DF4IAH/LandCruiser-Controller/README.md

# LandCruiser-Controller
µP controller for enabling LandCruisers for special tail-gates, alarms and multiple other features based on ATmega328P. Hardware (EAGLE), Software and Documentation is included.
