DF4IAH/LandCruiser-Controller/Docs/11_Brainstorming-Mindmap_Ideas/LandCruiser-Controller-Dateien/image001.png

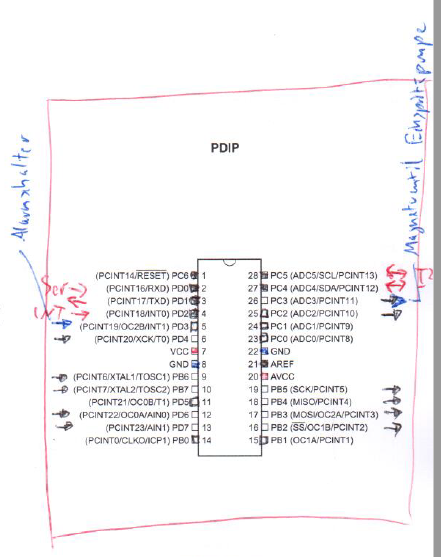
Docs/11_Brainstorming-Mindmap_Ideas/LandCruiser-Controller-Dateien/image001.png
