DF4IAH/LandCruiser-Controller/Docs/11_Brainstorming-Mindmap_Ideas/LandCruiser-Controller-Dateien/image002.png

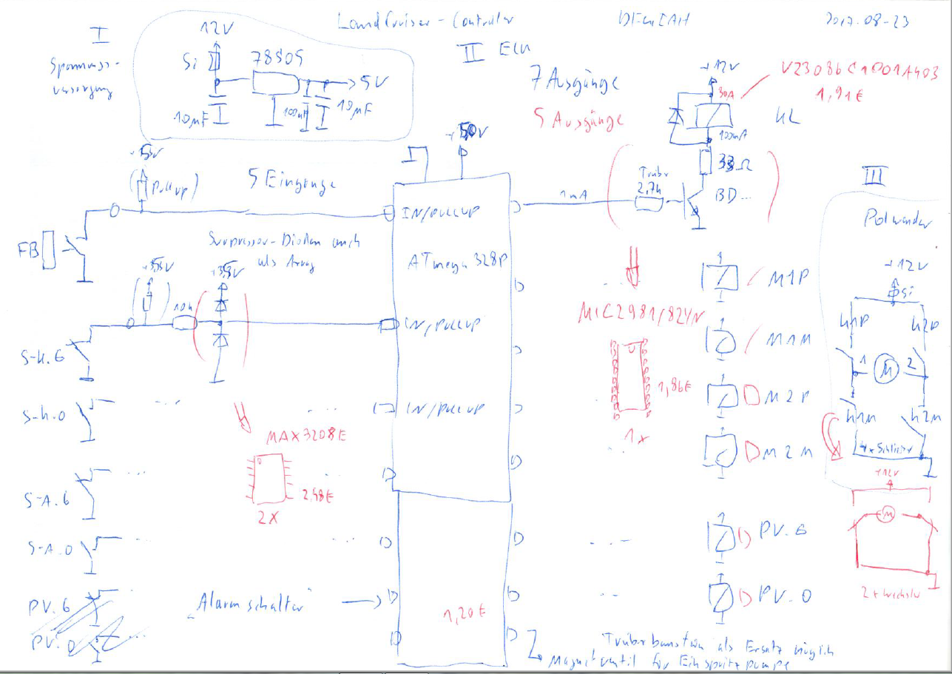
Docs/11_Brainstorming-Mindmap_Ideas/LandCruiser-Controller-Dateien/image002.png
