DF4IAH/LandCruiser-Controller/CAD/Eagle/LandCruiser-Controller_1V0.brd

## EAGLE design CAD/Eagle/LandCruiser-Controller_1V0.brd (2017-09-03)

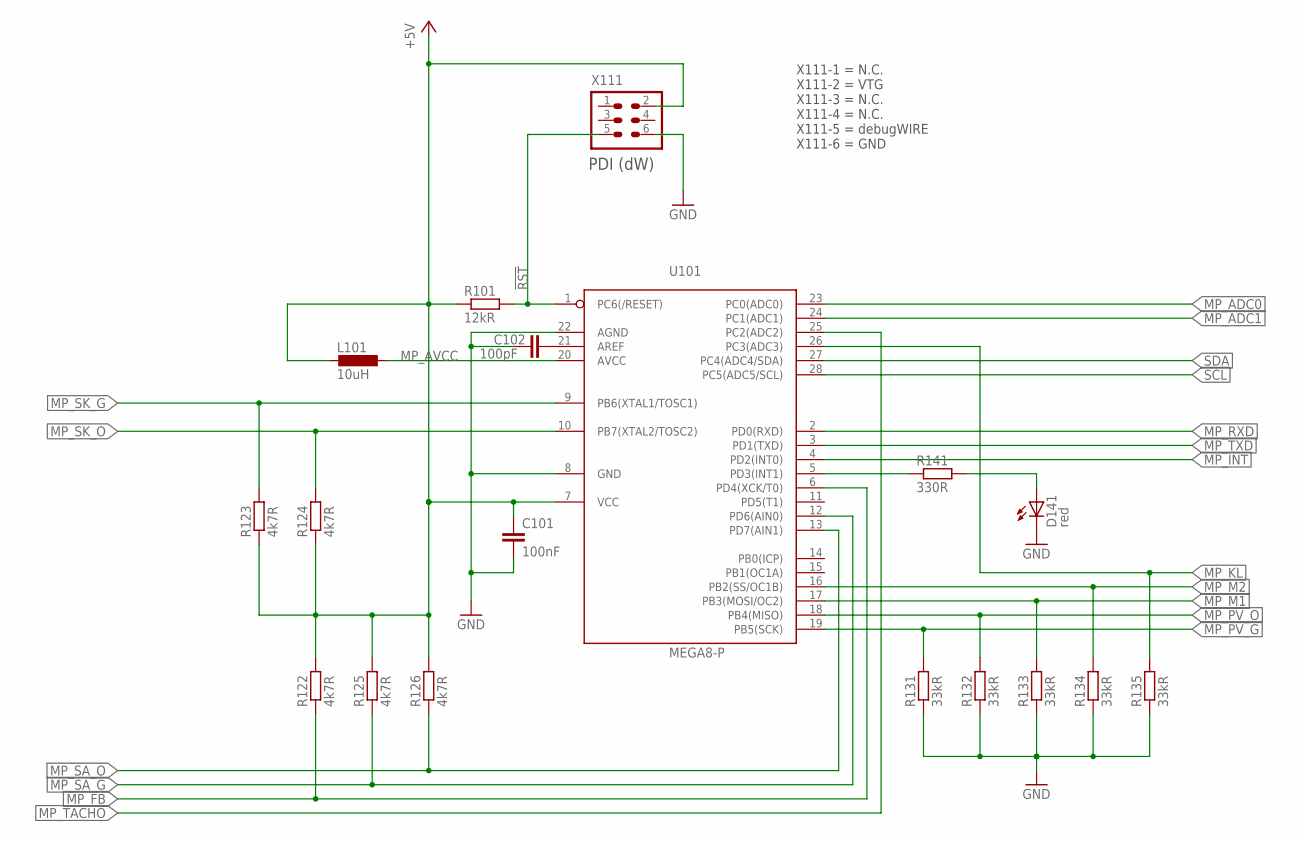
[picture p3: schematic LandCruiser-Controller_1V0.sch, sheet 1, MPU]

Parts:
C101: 100nF; C0805
C102: 100pF; C0805
D141: red; LED_2PIN-TTH
L101: 10uH; L1812
R101: 12kR; R0805
R122, R123, R124, R125, R126: 4k7R; R0805
R131, R132, R133, R134, R135: 33kR; R0805
R141: 330R; R0805
U101: MEGA8-P; DIL28-3
X111: HEADER-2X3; 2X03

Connections:
!RST: R101.2, U101.1 (PC6(/RESET)), X111.5
+5V: C101.1, L101.2, R101.1, R122.2, R123.1, R124.1, R125.2, R126.2, U101.7 (VCC), X111.2; also elsewhere on the board
GND: C101.2, C102.1, D141.C, R131.1, R132.1, R133.1, R134.1, R135.1, U101.8 (GND), U101.22 (AGND), X111.6; also elsewhere on the board
LED_A: D141.A, R141.2
MP_ADC0: U101.23 (PC0(ADC0)); also elsewhere on the board
MP_ADC1: U101.24 (PC1(ADC1))
MP_AREF: C102.2, U101.21 (AREF)
MP_AVCC: L101.1, U101.20 (AVCC)
MP_FB: R122.1, U101.6 (PD4(XCK/T0)); also elsewhere on the board
MP_INT: U101.4 (PD2(INT0))
MP_KL: R135.2, U101.26 (PC3(ADC3)); also elsewhere on the board
MP_LED: R141.1, U101.5 (PD3(INT1))
MP_M1: R133.2, U101.17 (PB3(MOSI/OC2)); also elsewhere on the board
MP_M2: R134.2, U101.16 (PB2(SS/OC1B)); also elsewhere on the board
MP_PV_G: R131.2, U101.19 (PB5(SCK)); also elsewhere on the board
MP_PV_O: R132.2, U101.18 (PB4(MISO)); also elsewhere on the board
MP_RXD: U101.2 (PD0(RXD)); also elsewhere on the board
MP_SA_G: R125.1, U101.12 (PD6(AIN0)); also elsewhere on the board
MP_SA_O: R126.1, U101.13 (PD7(AIN1)); also elsewhere on the board
MP_SK_G: R123.2, U101.9 (PB6(XTAL1/TOSC1)); also elsewhere on the board
MP_SK_O: R124.2, U101.10 (PB7(XTAL2/TOSC2)); also elsewhere on the board
MP_TACHO: U101.25 (PC2(ADC2)); also elsewhere on the board
MP_TXD: U101.3 (PD1(TXD)); also elsewhere on the board
SCL: U101.28 (PC5(ADC5/SCL)); also elsewhere on the board
SDA: U101.27 (PC4(ADC4/SDA)); also elsewhere on the board

Notes on the sheet:
PDI (dW)
X111-1 = N.C. X111-2 = VTG X111-3 = N.C. X111-4 = N.C. X111-5 = debugWIRE X111-6 = GND

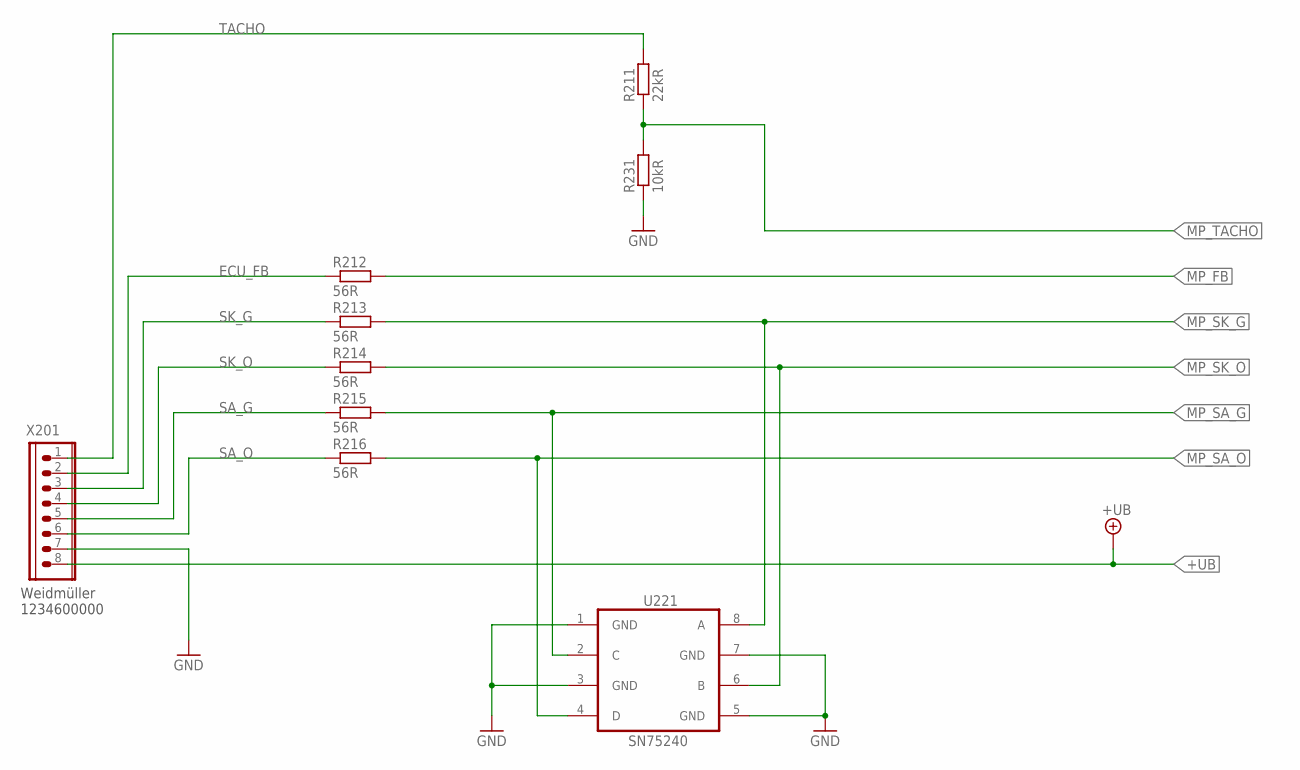
[picture p4: schematic LandCruiser-Controller_1V0.sch, sheet 2, INPUT_Lines]

Parts:
R211: 22kR; R0805
R212, R213, R214, R215, R216: 56R; R0805
R231: 10kR; R0805
U221: SN75240; TSSOP-8
X201: WEIDMUELLER 1234600000; WIRE-TO-BOARD_5MM08_1X08

Connections:
+UB: X201.8; also elsewhere on the board
ECU_FB: R212.1, X201.2
GND: R231.1, U221.1 (GND), U221.3 (GND), U221.5 (GND), U221.7 (GND), X201.7; also elsewhere on the board
MP_FB: R212.2; also elsewhere on the board
MP_SA_G: R215.2, U221.2 (C); also elsewhere on the board
MP_SA_O: R216.2, U221.4 (D); also elsewhere on the board
MP_SK_G: R213.2, U221.8 (A); also elsewhere on the board
MP_SK_O: R214.2, U221.6 (B); also elsewhere on the board
MP_TACHO: R211.1, R231.2; also elsewhere on the board
SA_G: R215.1, X201.5
SA_O: R216.1, X201.6
SK_G: R213.1, X201.3
SK_O: R214.1, X201.4
TACHO: R211.2, X201.1

Notes on the sheet:
Weidmüller 1234600000

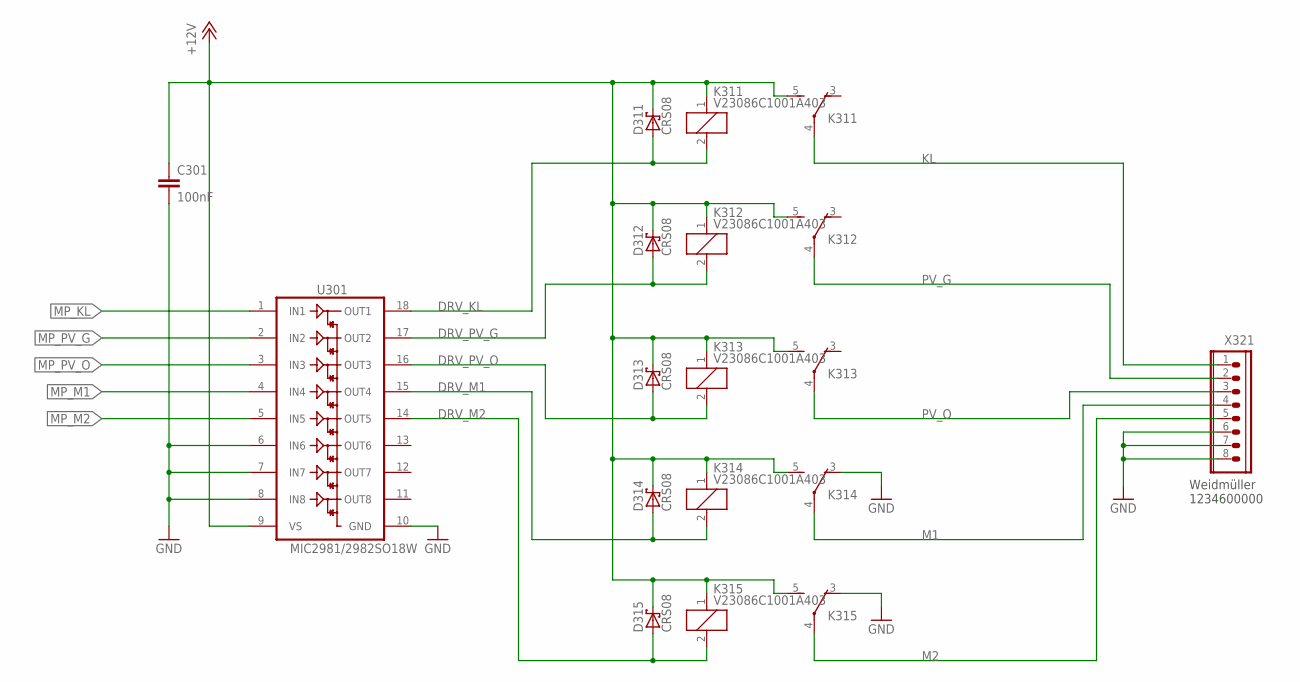
[picture p5: schematic LandCruiser-Controller_1V0.sch, sheet 3, OUTPUT_Lines]

Parts:
C301: 100nF; C0805
D311, D312, D313, D314, D315: CRS08; SOD80C
K311, K312, K313, K314, K315: V23086C1001A403; V23086-CO
U301: MIC2981/2982SO18W; SO-18W
X321: WEIDMUELLER 1234600000; WIRE-TO-BOARD_5MM08_1X08

Connections:
+12V: C301.1, D311.C, D312.C, D313.C, D314.C, D315.C, K311.1, K311.5 (S), K312.1, K312.5 (S), K313.1, K313.5 (S), K314.1, K314.5 (S), K315.1, K315.5 (S), U301.9 (VS); also elsewhere on the board
DRV_KL: D311.A, K311.2, U301.18 (OUT1)
DRV_M1: D314.A, K314.2, U301.15 (OUT4)
DRV_M2: D315.A, K315.2, U301.14 (OUT5)
DRV_PV_G: D312.A, K312.2, U301.17 (OUT2)
DRV_PV_O: D313.A, K313.2, U301.16 (OUT3)
GND: C301.2, K314.3 (O), K315.3 (O), U301.6 (IN6), U301.7 (IN7), U301.8 (IN8), U301.10 (GND), X321.6, X321.7, X321.8; also elsewhere on the board
KL: K311.4, X321.1
M1: K314.4, X321.4
M2: K315.4, X321.5
MP_KL: U301.1 (IN1); also elsewhere on the board
MP_M1: U301.4 (IN4); also elsewhere on the board
MP_M2: U301.5 (IN5); also elsewhere on the board
MP_PV_G: U301.2 (IN2); also elsewhere on the board
MP_PV_O: U301.3 (IN3); also elsewhere on the board
PV_G: K312.4, X321.2
PV_O: K313.4, X321.3

Notes on the sheet:
Weidmüller 1234600000

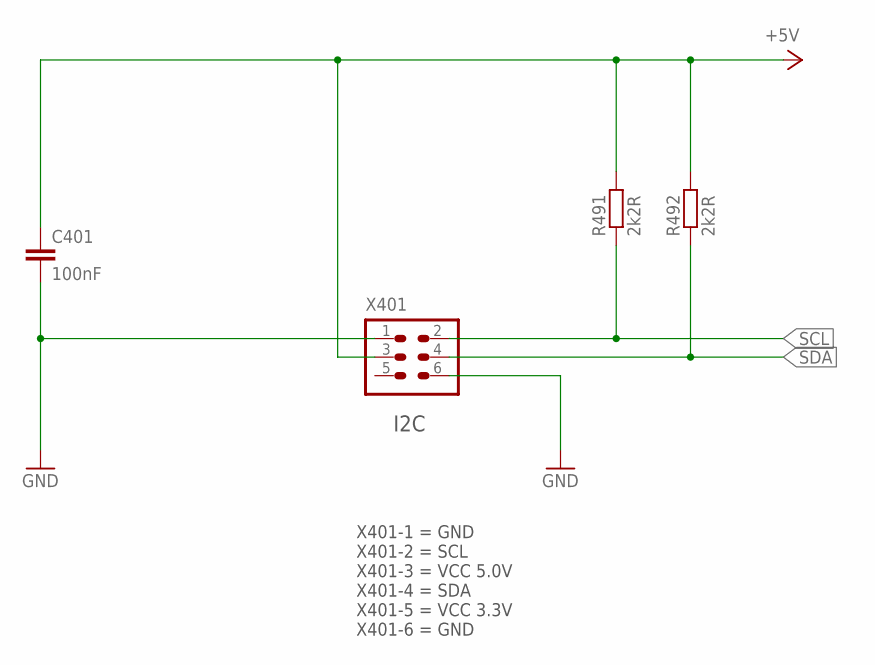
[picture p6: schematic LandCruiser-Controller_1V0.sch, sheet 4, I2C connector]

Parts:
C401: 100nF; C0805
R491, R492: 2k2R; R0805
X401: I2C; 2X03

Connections:
+5V: C401.1, R491.2, R492.2, X401.3; also elsewhere on the board
GND: C401.2, X401.1, X401.6; also elsewhere on the board
SCL: R491.1, X401.2; also elsewhere on the board
SDA: R492.1, X401.4; also elsewhere on the board

Notes on the sheet:
I2C
X401-1 = GND X401-2 = SCL X401-3 = VCC 5.0V X401-4 = SDA X401-5 = VCC 3.3V X401-6 = GND

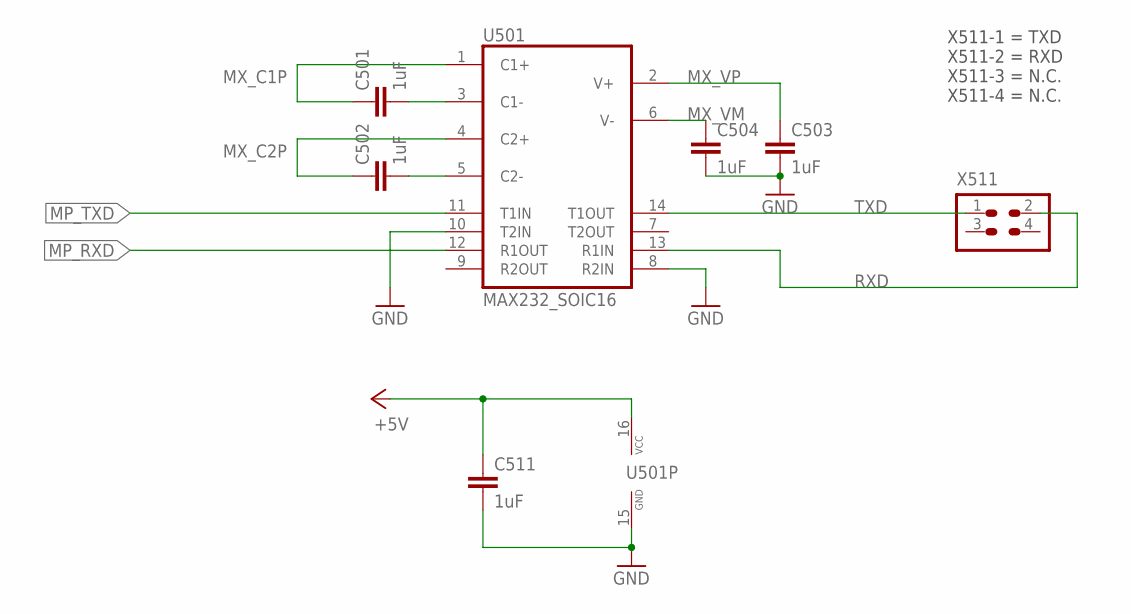
[picture p7: schematic LandCruiser-Controller_1V0.sch, sheet 5, V24 level shifter]

Parts:
C501, C502, C503, C504, C511: 1uF; C0805
U501: MAX232_SOIC16; SOIC16N
X511: HEADER-2X2; 2X02

Connections:
+5V: C511.1, U501.16 (VCC); also elsewhere on the board
GND: C503.2, C504.2, C511.2, U501.8 (R2IN), U501.10 (T2IN), U501.15 (GND); also elsewhere on the board
MP_RXD: U501.12 (R1OUT); also elsewhere on the board
MP_TXD: U501.11 (T1IN); also elsewhere on the board
MX_C1N: C501.2, U501.3 (C1-)
MX_C1P: C501.1, U501.1 (C1+)
MX_C2M: C502.2, U501.5 (C2-)
MX_C2P: C502.1, U501.4 (C2+)
MX_VM: C504.1, U501.6 (V-)
MX_VP: C503.1, U501.2 (V+)
RXD: U501.13 (R1IN), X511.2
TXD: U501.14 (T1OUT), X511.1

Notes on the sheet:
X511-1 = TXD X511-2 = RXD X511-3 = N.C. X511-4 = N.C.

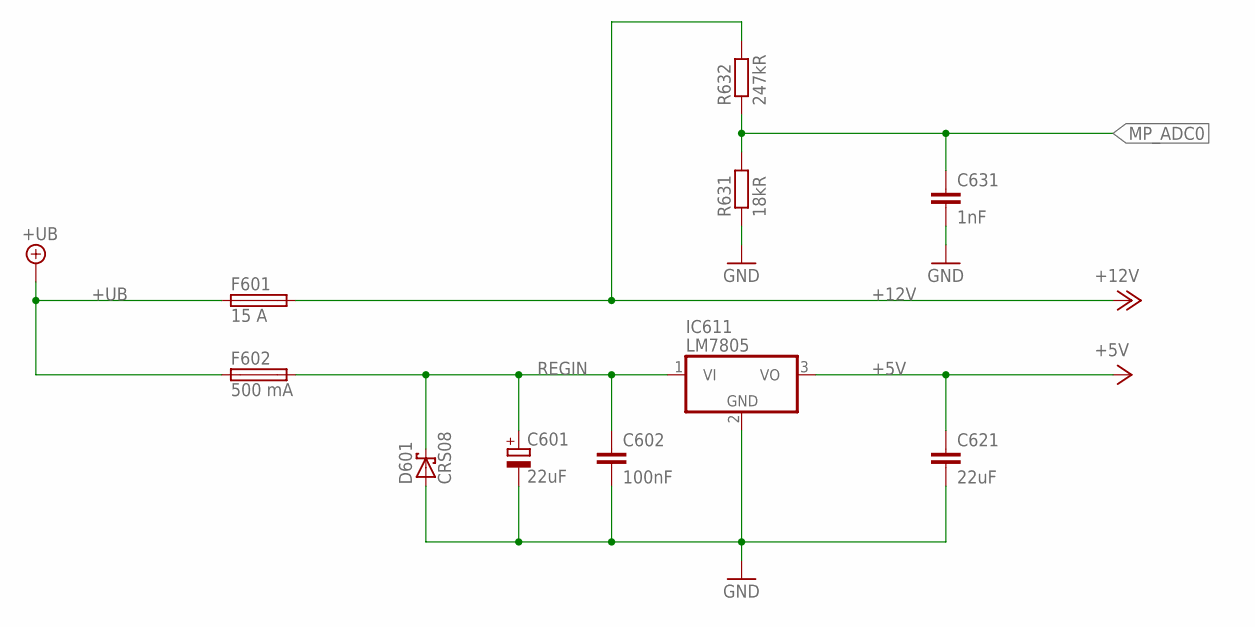
[picture p8: schematic LandCruiser-Controller_1V0.sch, sheet 6, Power]

Parts:
C601: 22uF; E2,5-7
C602: 100nF; C0805
C621: 22uF; C0805
C631: 1nF; C0805
D601: CRS08; SOD80C
F601: 15 A; MCCQ-121
F602: 500 mA; MCCQ-121
IC611: LM7805; TO220H
R631: 18kR; R0805
R632: 247kR; R0805

Connections:
+5V: C621.1, IC611.3 (VO); also elsewhere on the board
+12V: F601.3 (2), F601.4 (2), R632.2; also elsewhere on the board
+UB: F601.1, F601.2 (1), F602.1, F602.2 (1); also elsewhere on the board
GND: C601.-, C602.2, C621.2, C631.2, D601.A, IC611.2 (GND), R631.1; also elsewhere on the board
MP_ADC0: C631.1, R631.2, R632.1; also elsewhere on the board
REGIN: C601.+, C602.1, D601.C, F602.3 (2), F602.4 (2), IC611.1 (VI)

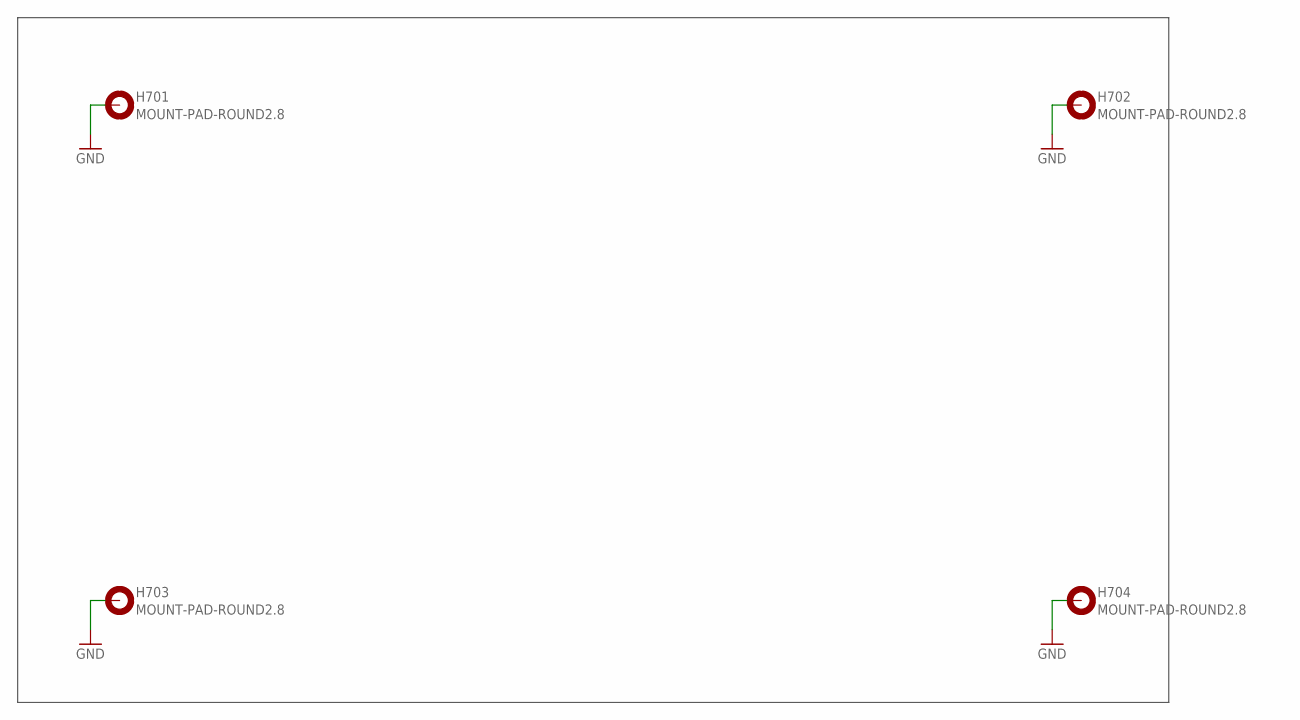
[picture p9: schematic LandCruiser-Controller_1V0.sch, sheet 7, Holes]

Parts:
H701, H702, H703, H704: MOUNT-PAD-ROUND2.8; 2,8-PAD

Connections:
GND: H701.B2,8, H702.B2,8, H703.B2,8, H704.B2,8; also elsewhere on the board

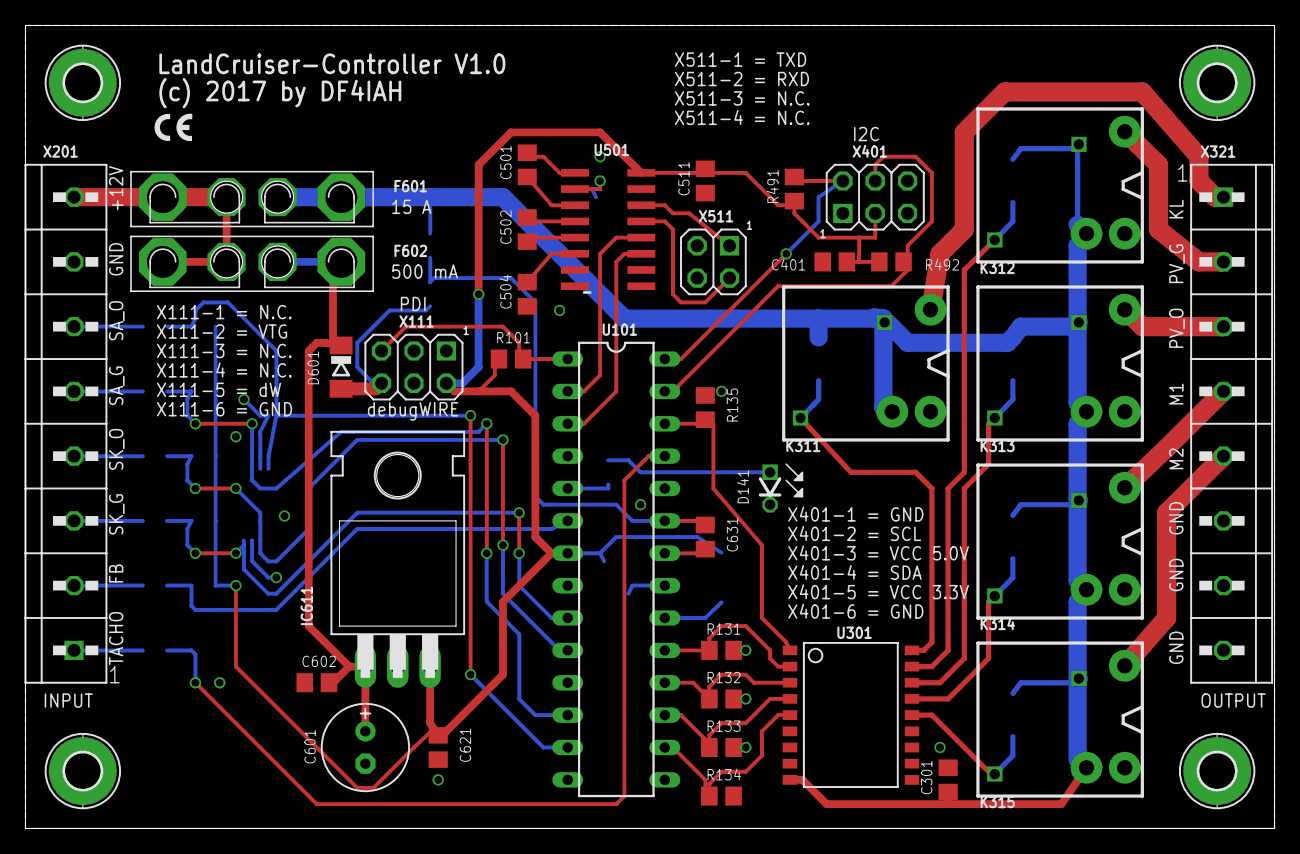
[picture p10: board LandCruiser-Controller_1V0.brd from above]

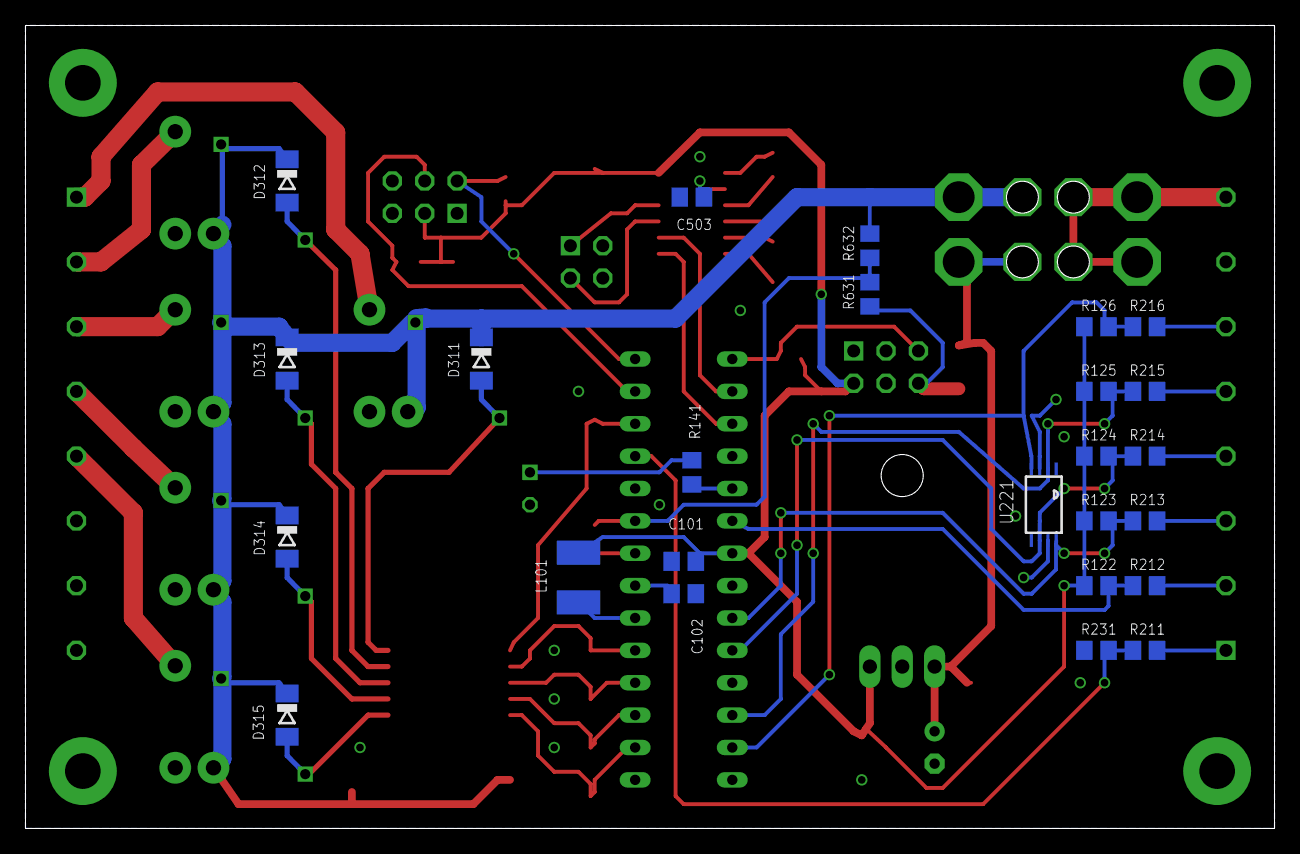
[picture p11: board LandCruiser-Controller_1V0.brd from below]

Board: 2 copper layers, 98.0 x 63.0 mm, 65 parts (25 on the bottom side), 50 nets.
