DF4IAH/LandCruiser-Controller/LandCruiser-Controller_SW/LandCruiser-Controller_SW/src/main.h

/*
 * main.h
 *
 * Created: 25.08.2017 20:55:00
 * Author: DF4IAH
 */


#ifndef MAIN_H_
#define MAIN_H_

//#include <gfx_mono/gfx_mono.h>

//#include "twi.h"


/* ATmega 328P - fuses ext:0xFD hi:0xB7 lo:0xE2 */


/* VERSION: YYM, MDD */
#define VERSION_HIGH												180
#define VERSION_LOW													203

/* I2C-Version V1.1 */
#define I2C_VERSION													0x11


/* TC1 timer runs @ 8MHz/DIV8 = overflows every 1 ms */
#define C_TC1_TOP_VAL												(500 - 1)

/* Task runs with this intervals */
#define C_TASK_TIMESPAN												10

/* Remote control timer */
#define C_FB_PRESS_SHORT_TIME										500
#define C_FB_PRESS_LONG_TIME										1000

/* Securing valve timer */
#define C_PV_ACTION_TIME											1000
#define C_PV_SILENCE_TIME											650

/* Minimum period = maximum speed to allow FSM to proceed */
#define C_TICKS_MAXSPEED											100

/* Blink code number of digits */
#define C_LED_DIGITS												2


typedef enum C_ADC_STATE__ENUM {
	C_ADC_STATE_VLD_12V												=  0,
	C_ADC_STATE_VLD_TEMP,
} C_ADC_STATE__ENUM_t;


enum C_SMART_LCD_MODE__ENUM {
	C_SMART_LCD_MODE_UNIQUE											= 0x00,
	C_SMART_LCD_MODE_SMARTLCD										= 0x10,
};

enum C_EEPROM_ADDR__ENUM {
	C_EEPROM_ADDR_VERSION											= 0x00,
	C_EEPROM_ADDR_LCD_PM											= 0x10,
};

enum C_EEPROM_NVM_SETTING__ENUM {
	C_EEPROM_NVM_SETTING_LCD_CONTRAST								= 0x01,
	C_EEPROM_NVM_SETTING_VERSION									= 0x80,
	C_EEPROM_NVM_SETTING_ALL										= 0xFF
};


#ifndef	TWI_SMART_LCD_SLAVE_BUF_LEN
# define TWI_SMART_LCD_SLAVE_BUF_LEN								16
#endif
typedef struct showData {
	uint16_t	newClkState											: 1;
	uint16_t	newDate												: 1;
	uint16_t	newTime												: 1;
	uint16_t	newSatUse											: 1;
	uint16_t	newSatDop											: 1;
	uint16_t	newPosState											: 1;
	uint16_t	newPosLat											: 1;
	uint16_t	newPosLon											: 1;
	uint16_t	newPosHeight										: 1;
	uint16_t	newRsvrd											: 7;

	uint8_t				cmd;
	uint8_t				data[TWI_SMART_LCD_SLAVE_BUF_LEN];

	#if 0
	gfx_mono_color_t	pixelType;
	gfx_coord_t			pencil_x;
	gfx_coord_t			pencil_y;
	#endif

	uint8_t		clkState_clk_state;
	uint8_t		date_month;
	uint8_t		date_day;
	uint8_t		time_hour;
	uint8_t		time_minute;
	uint8_t		time_second;
	uint8_t		satUse_west;
	uint8_t		satUse_east;
	uint8_t		satUse_used;
	uint8_t		posState_fi;
	uint8_t		posState_m2;
	uint8_t		posLat_sgn;
	uint8_t		posLat_deg;
	uint8_t		posLat_min_int;
	uint8_t		posLon_sgn;
	uint8_t		posLon_deg;
	uint8_t		posLon_min_int;
	uint8_t		pos_height_frac10;

} showData_t;


/* LED blink code queue */

#define C_BC_DIGITS						2
#define C_BC_T_LEN						(((5 * 2 + 1) * C_BC_DIGITS) + 1 + 1)
#define C_LED_DOT_ON_TIME_MS			100
#define C_LED_DOT_OFF_TIME_MS			200
#define C_LED_INTERDOT_TIME_MS			750
#define C_LED_CODEEND_TIME_MS			1500


typedef enum led_bc_q_entry_o_ENUM {
	LED_OFF			= 0x00,
	LED_ON			= 0x01,
	LED_LIST_END	= 0xff,
} led_bc_q_entry_o_t;

typedef struct led_bc_q_entry {
	led_bc_q_entry_o_t	op;				// operation
	uint16_t			delta_ms;		// duration of an operation
} led_bc_q_entry_t;


/* UTILITIES section */
void led_set(bool doOutput, bool setHigh);
void led_blink_code_set(uint32_t code);
uint8_t led_blink_code_enqueue(void);
void my_adc_init(uint8_t mux);
void my_adc_disable(void);
uint64_t get_abs_time_ms(void);
void mem_set(uint8_t* buf, uint8_t count, uint8_t val);
void eeprom_nvm_settings_write(uint8_t flags);
void eeprom_nvm_settings_read(uint8_t flags);


/* TASK section */
void task(uint64_t timestamp);
void enter_sleep(uint8_t sleep_mode);
void halt(void);


/* MAIN section */
int main(void);


#endif /* MAIN_H_ */
