DF4IAH/LandCruiser-Controller/LandCruiser-Controller_SW/LandCruiser-Controller_SW/src/isr.h

/*
 * isr.h
 *
 * Created: 25.08.2017 20:55:00
 * Author: DF4IAH
 */


#ifndef ISR_H_
#define ISR_H_


#if 0
enum ADC_STATES {
	ADC_STATE_PRE_LDR = 0,
	ADC_STATE_VLD_LDR,
	ADC_STATE_PRE_TEMP,
	ADC_STATE_VLD_TEMP,

	ADC_STATE__COUNT
};
#endif

enum TWI_FSM_STATUS {
	TWI_FSM_STATUS_BLOCKING_BM = _BV(0),
};


/* Helper functions */
void asm_break(void);

void process_adc(void);


#endif /* ISR_H_ */
