DF4IAH/LandCruiser-Controller/LandCruiser-Controller_SW/LandCruiser-Controller_SW/src/config/conf_clock.h

/**
 * \file
 *
 * \brief Chip-specific system clock manager configuration
 *
 * Copyright (c) 2014-2015 Atmel Corporation. All rights reserved.
 *
 * \asf_license_start
 *
 * \page License
 *
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
 * 3. The name of Atmel may not be used to endorse or promote products derived
 *    from this software without specific prior written permission.
 *
 * 4. This software may only be redistributed and used in connection with an
 *    Atmel microcontroller product.
 *
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
 * \asf_license_stop
 *
 */
/*
 * Support and FAQ: visit <a href="http://www.atmel.com/design-support/">Atmel Support</a>
 */
#ifndef CONF_CLOCK_H_INCLUDED
#define CONF_CLOCK_H_INCLUDED

/* ===== System Clock Source Options */
#define SYSCLK_SRC_RC16MHZ    0
#define SYSCLK_SRC_RC128KHZ   1
#define SYSCLK_SRC_TRS16MHZ   2
#define SYSCLK_SRC_RC32KHZ    3
#define SYSCLK_SRC_XOC16MHZ   4
#define SYSCLK_SRC_EXTERNAL   5

/* =====  Select connected clock source */
#define  SYSCLK_SOURCE         SYSCLK_SRC_RC16MHZ
/* #define SYSCLK_SOURCE        SYSCLK_SRC_RC128KHZ */
/* #define SYSCLK_SOURCE        SYSCLK_SRC_TRS16MHZ */
/* #define SYSCLK_SOURCE        SYSCLK_SRC_XOC16MHZ */

/* ===== System Clock Bus Division Options */
#define CONFIG_SYSCLK_PSDIV     SYSCLK_PSDIV_1
//#define CONFIG_SYSCLK_PSDIV   SYSCLK_PSDIV_8

#endif /* CONF_CLOCK_H_INCLUDED */
