DF4IAH/LandCruiser-Controller/(commit log)

2017-08-23 HW_V1.0 - CAD directory added
2017-08-24 HW_V1.0 - initial hardware set-up
    [LandCruiser-Controller_1V0.brd, LandCruiser-Controller_1V0.sch]
2017-08-25 HW - pull-down resistors added to the ATmega output lines
    [LandCruiser-Controller_1V0.brd, LandCruiser-Controller_1V0.sch]
2017-08-25 SW - I/O settings done, TC1 timer running with 1 kHz overflow frequency
2017-08-26 SW - avrdude - scripts for erasing, burning fuses, EEPROM and FLASH expanded
2017-08-26 HW - pull-up resistors added to the ATmega input lines
    [LandCruiser-Controller_1V0.brd, LandCruiser-Controller_1V0.sch]
2017-08-27 SW - FSM - now working with ne-noising and direction reversal
    [main.c, main.h]
2017-08-27 SW - FSM - fix added for the case S-K_O opens during arms are not in close position
    [main.c, main.h]
2017-08-27 HW - Linear voltage regulator 7805 added
    [LandCruiser-Controller_1V0.brd, LandCruiser-Controller_1V0.sch]
2017-08-28 DOCS - Datasheets 91_Wire-to-Board-Connectors - added
2017-08-28 HW - Wire-to-Board connectors added
    [LandCruiser-Controller_1V0.brd, LandCruiser-Controller_1V0.sch]
2017-08-29 HW_V1.0 - ESD - circuits added
    [LandCruiser-Controller_1V0.brd, LandCruiser-Controller_1V0.sch]
2017-08-29 HW_V1.0 - Driver - circuit added
    [LandCruiser-Controller_1V0.brd, LandCruiser-Controller_1V0.sch]
2017-08-29 HW_V1.0 - Relay - pre-works done
    [LandCruiser-Controller_1V0.brd, LandCruiser-Controller_1V0.sch]
2017-08-29 HW - V24 level shifter - new page with frame added
    [LandCruiser-Controller_1V0.brd, LandCruiser-Controller_1V0.sch]
2017-08-30 HW_V1.0 - MPU - AVCC with 10uH for better ADC results
    [LandCruiser-Controller_1V0.brd, LandCruiser-Controller_1V0.sch]
2017-08-30 HW_V1.0 - OUTPUT - relay units added
    [LandCruiser-Controller_1V0.brd, LandCruiser-Controller_1V0.sch]
2017-08-30 DOCS - Fuses - multicomp MCCQ-121 added
2017-08-30 HW_V1.0 - V24 level shifter connected, Tacho input signal added
    [LandCruiser-Controller_1V0.brd, LandCruiser-Controller_1V0.sch]
2017-08-31 HW_V1.0 - changed most devices to SMD variants
    [LandCruiser-Controller_1V0.brd, LandCruiser-Controller_1V0.sch]
2017-08-31 HW_V1.0 - df4iah_fuse.lbr - trying to fix the restring issue
    [LandCruiser-Controller_1V0.brd, LandCruiser-Controller_1V0.sch]
2017-08-31 HW_V1.0 - Place&Routing - placement done, half of the routing done
    [LandCruiser-Controller_1V0.brd, LandCruiser-Controller_1V0.sch]
2017-09-01 HW_V1.0 - Routing - routing finished, no ground polygone here
    [LandCruiser-Controller_1V0.brd]
2017-09-01 HW_V1.0 - Routing - now with ground polygone
    [LandCruiser-Controller_1V0.brd]
2017-09-01 HW_V1.0 - Routing - GND vias added, place below the LM7805 cleared
    [LandCruiser-Controller_1V0.brd]
2017-09-01 HW_V1.0 - additional capacitors added
    [LandCruiser-Controller_1V0.brd, LandCruiser-Controller_1V0.sch]
2017-09-02 HW_V1.0 - status LED added, ADC0 connected to 15:1 divider for 12V control
    [LandCruiser-Controller_1V0.brd, LandCruiser-Controller_1V0.sch]
2017-09-03 HW_V1.0 - dimension values rounded, pad below the LM7805 restricted
    [LandCruiser-Controller_1V0.brd]
2017-09-03 HW_V1.0 - fuse drillings added - V1.0 finished and ordered
    [LandCruiser-Controller_1V0.brd, LandCruiser-Controller_1V0.sch]
2017-09-03 HW_V1.1 - new version added
    [LandCruiser-Controller_1V1.brd, LandCruiser-Controller_1V1.sch]
2017-09-03 SW - LED and ADC0/ADC1 channels added
2017-09-06 SW - ADC0/Temp - measurements and calculations fixed
    [isr.c, main.c, main.h]
2017-09-07 SW - ADC0 - under-voltage detection added
2017-09-09 SW - over-speed detection fixed
    [isr.c, main.c]
2017-09-16 SW - Status LED for counting seconds added
2017-10-17 HW_V1.1 - driver switches against ground, not Vbat. Another input line added.
    [LandCruiser-Controller_1V1.brd, LandCruiser-Controller_1V1.sch]
2017-10-19 SW - LED blink codes added, FSM states now blink code values
2017-10-27 SW - LED blink codes added, FSM states now blink code values (2)
2017-10-30 SW - UART output by 38,400 baud 8N1
2017-11-01 SW - FSM state, input vector and output vector changes are reported via UART
2017-11-01 SW - switched FB input with rear tail gate (SH_G)
2017-11-01 HW_V1.1 - switched FB input with rear tail gate (SH_G)
    [LandCruiser-Controller_1V1.brd, LandCruiser-Controller_1V1.sch]
2017-12-10 HW_V1.2 - new version added
    [LandCruiser-Controller_1V2.brd, LandCruiser-Controller_1V2.sch]
2017-12-10 HW_V1.0 - again included in master branch
    [LandCruiser-Controller_1V0.brd, LandCruiser-Controller_1V0.sch]
2017-12-10 HW_V1.1 - again included in master branch
    [LandCruiser-Controller_1V1.brd, LandCruiser-Controller_1V1.sch]
2017-12-10 SW - ADC fixed, FSM fixed, ready-to-run
    [externals.h, isr.c, isr.h, main.c, main.h, serial.c, serial.h]
2018-02-01 SW - broken LED code fixed
    [externals.h, isr.h, main.c, main.h, serial.h]
2018-02-02 SW - remove wrong include file
    [conf_clock.h]
