DF4IAH/LandCruiser-Controller/(notices)

Notices in the files:
CAD/Eagle/LandCruiser-Controller_1V2.brd:
(C) 2017 by DF4IAH
